kout520/Water_Outage_Treasure/(list of files, cad)

Other CAD files:
嵌赛系统.dwg
