kout520/Water_Outage_Treasure/CH32V307VCT/code/headfile.h

#ifndef _headfile_h_
#define _headfile_h_

#include "ch32v30x.h" 
#include "debug.h"
#include "ch32v30x_conf.h"

#include "stdio.h"
#include "stdint.h"
#include "string.h"

#include "key.h"
#include "pwm.h"
#include "timer.h"
#include "lcd.h"
#include "fun.h"
#include "tjc_usart_hmi.h"
#include"water_speed.h"
#include"water_quality.h"
#include"esp32_concert.h"
#include"adc_going.h"
#include"zigbee.h"

#endif
