kout520/Water_Outage_Treasure/CH32V307VCT_1/code/adc_going.c

#include "headfile.h"

// ============================================================
// ADC DMA采集: PA4=水位, PA5=湿度
// ============================================================

u16 ADC_ConvertedValue[ADC_BUF_LEN];

// ADC GPIO + ADC初始化
static void adc_Init(void)
{
    GPIO_InitTypeDef GPIO_InitStructure = {0};
    ADC_InitTypeDef  ADC_InitStructure = {0};

    RCC_APB2PeriphClockCmd(RCC_APB2Periph_GPIOA | RCC_APB2Periph_ADC1, ENABLE);
    RCC_ADCCLKConfig(RCC_PCLK2_Div6);

    // PA5 = 湿度模拟输入 (PA4已用于HC-SR04 ECHO)
    GPIO_InitStructure.GPIO_Pin = GPIO_Pin_5;
    GPIO_InitStructure.GPIO_Mode = GPIO_Mode_AIN;
    GPIO_Init(GPIOA, &GPIO_InitStructure);

    ADC_InitStructure.ADC_Mode = ADC_Mode_Independent;
    ADC_InitStructure.ADC_ScanConvMode = ENABLE;
    ADC_InitStructure.ADC_ContinuousConvMode = ENABLE;
    ADC_InitStructure.ADC_ExternalTrigConv = ADC_ExternalTrigConv_None;
    ADC_InitStructure.ADC_DataAlign = ADC_DataAlign_Right;
    ADC_InitStructure.ADC_NbrOfChannel = ADC_BUF_LEN;
    ADC_Init(ADC1, &ADC_InitStructure);

    ADC_Cmd(ADC1, ENABLE);

    ADC_ResetCalibration(ADC1);
    while (ADC_GetResetCalibrationStatus(ADC1));
    ADC_StartCalibration(ADC1);
    while (ADC_GetCalibrationStatus(ADC1));
}

// DMA初始化
static void DMA_Tx_Init(void)
{
    DMA_InitTypeDef DMA_InitStructure = {0};

    RCC_AHBPeriphClockCmd(RCC_AHBPeriph_DMA1, ENABLE);
    DMA_DeInit(DMA1_Channel1);

    DMA_InitStructure.DMA_PeripheralBaseAddr = (u32)&ADC1->RDATAR;
    DMA_InitStructure.DMA_MemoryBaseAddr = (u32)ADC_ConvertedValue;
    DMA_InitStructure.DMA_DIR = DMA_DIR_PeripheralSRC;
    DMA_InitStructure.DMA_BufferSize = ADC_BUF_LEN;
    DMA_InitStructure.DMA_PeripheralInc = DMA_PeripheralInc_Disable;
    DMA_InitStructure.DMA_MemoryInc = DMA_MemoryInc_Enable;
    DMA_InitStructure.DMA_PeripheralDataSize = DMA_PeripheralDataSize_HalfWord;
    DMA_InitStructure.DMA_MemoryDataSize = DMA_MemoryDataSize_HalfWord;
    DMA_InitStructure.DMA_Mode = DMA_Mode_Circular;
    DMA_InitStructure.DMA_Priority = DMA_Priority_High;
    DMA_InitStructure.DMA_M2M = DMA_M2M_Disable;
    DMA_Init(DMA1_Channel1, &DMA_InitStructure);

    DMA_Cmd(DMA1_Channel1, ENABLE);
}

// ADC DMA总初始化
void ADC_DMA_CONF(void)
{
    adc_Init();
    DMA_Tx_Init();

    // CH5=湿度(PA5), PA4已用于HC-SR04
    ADC_RegularChannelConfig(ADC1, ADC_Channel_5, 1, ADC_SampleTime_55Cycles5);

    ADC_DMACmd(ADC1, ENABLE);
    ADC_SoftwareStartConvCmd(ADC1, ENABLE);
}

// ============================================================
// 获取湿度 (%)
// ============================================================
float ADC_GetHumidity(void)
{
    float voltage_ratio = (float)ADC_ConvertedValue[0] / 4095.0f;
    return voltage_ratio * 100.0f;
}
