kout520/Water_Outage_Treasure/(commit log)

2026-04-16 提交说明
2026-07-19 我更新了XXX功能
    [嵌赛系统.dwg]
